ArsenyVekshin/UMK-32/(commit log)

2024-10-01 Update TZ.md
    экономику посчитал
2024-10-01 Update TZ.md
    требования к документации
